sreekondapalli17/neonwrist/(list of files, drawings)

Other design files:
pcb/neonwrist/neonwrist.dsn
pcb/neonwrist/temp-freerouting.dsn
