sreekondapalli17/neonwrist/pcb/neonwrist/neonwrist.kicad_pcb

## KiCad design pcb/neonwrist/neonwrist.kicad_pcb (2026-11-05)

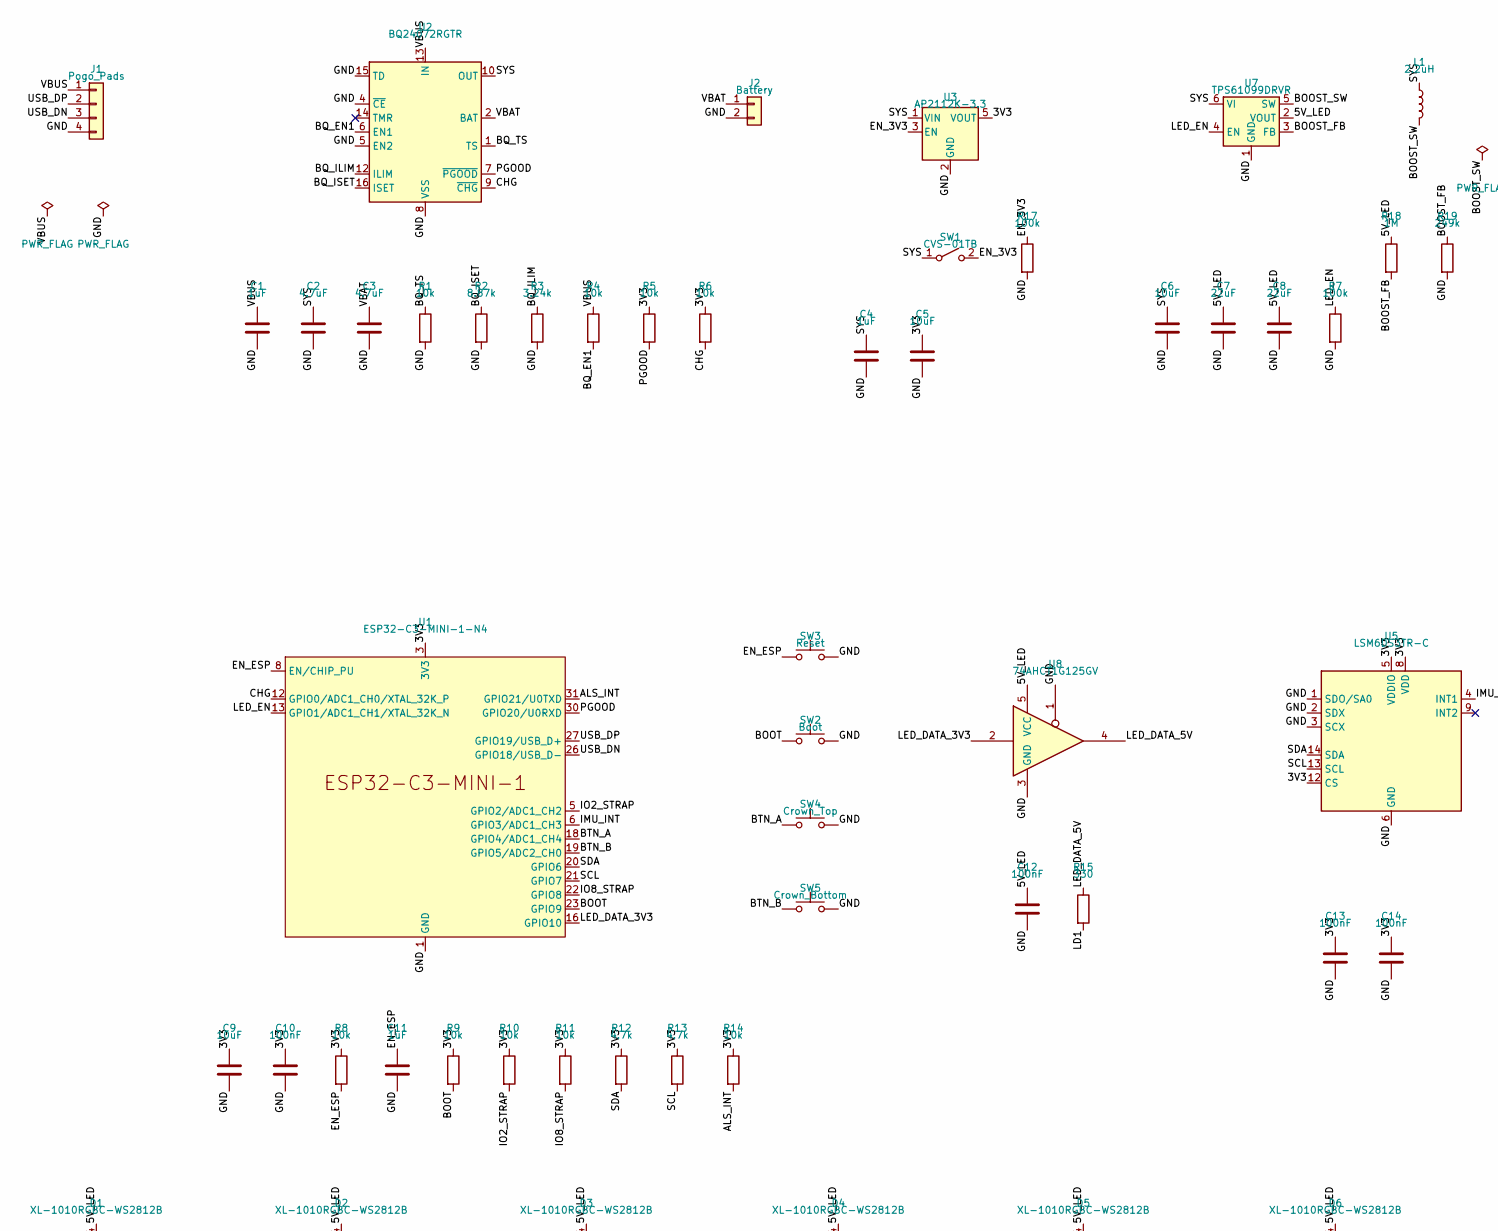
[picture p1: schematic neonwrist.kicad_sch, NEON//WRIST MK-II main board, part in row 1, column 1]

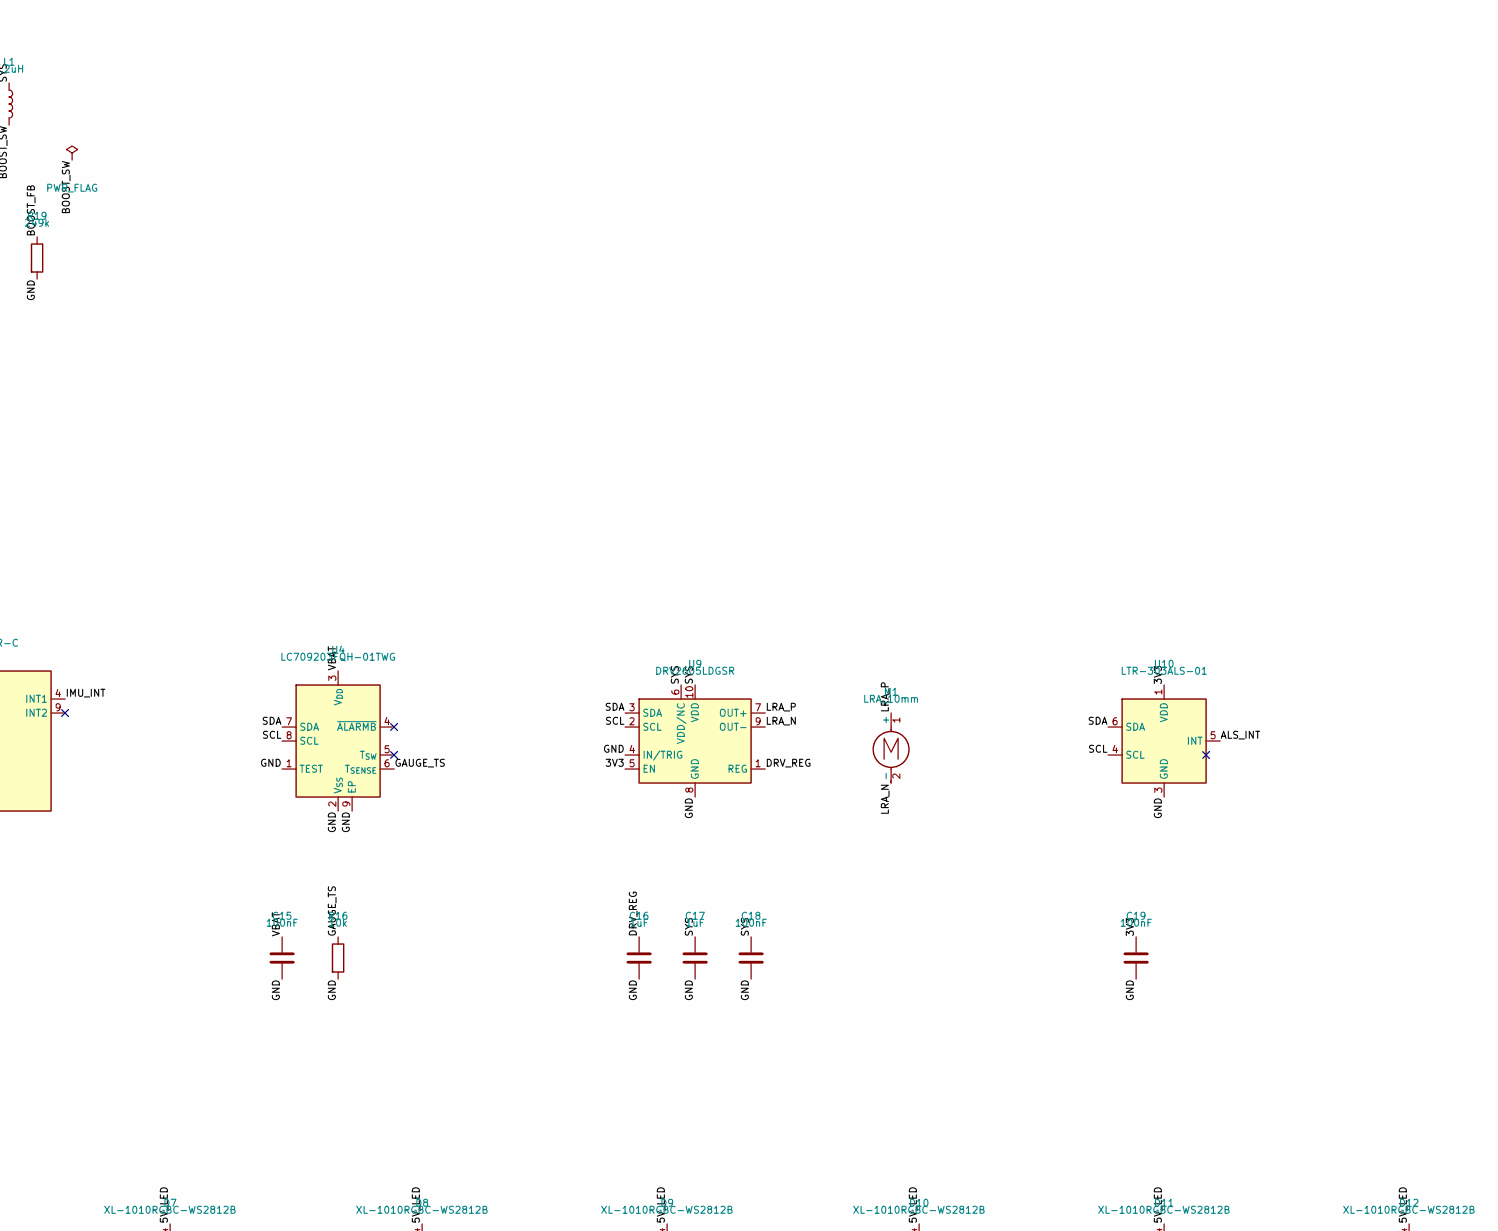
[picture p2: schematic neonwrist.kicad_sch, NEON//WRIST MK-II main board, part in row 1, column 2]

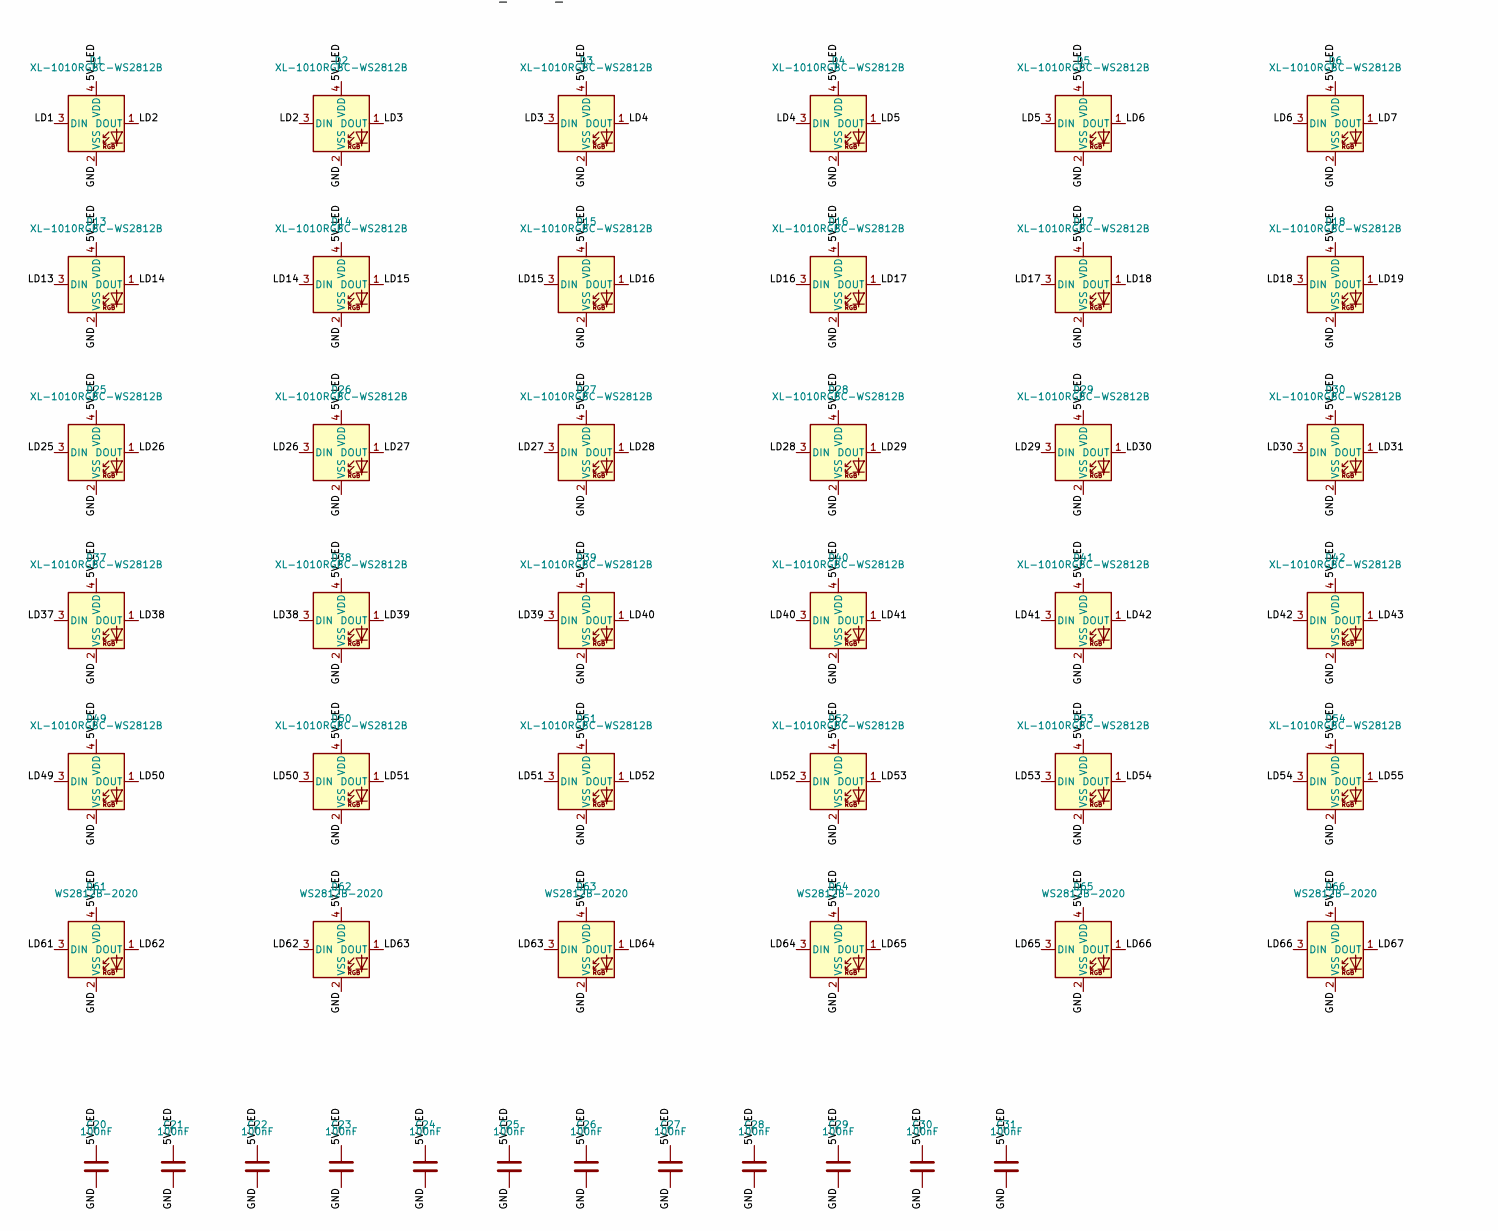
[picture p3: schematic neonwrist.kicad_sch, NEON//WRIST MK-II main board, part in row 2, column 1]

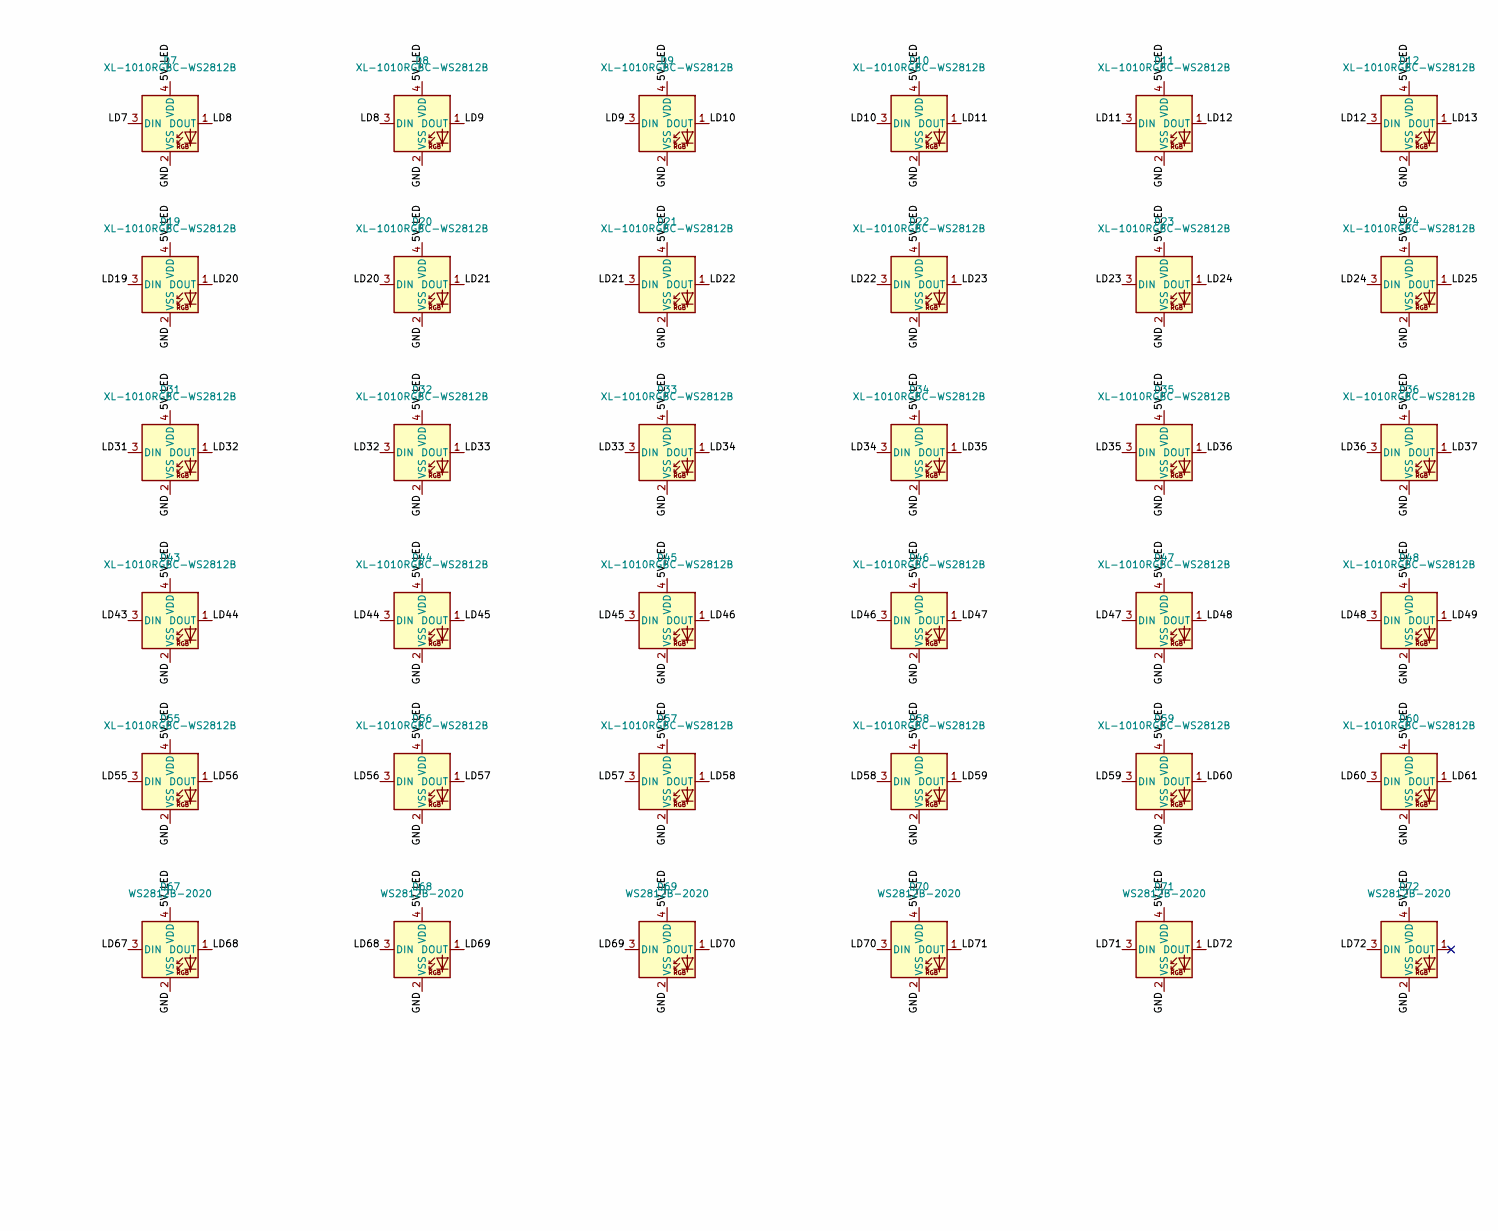
[picture p4: schematic neonwrist.kicad_sch, NEON//WRIST MK-II main board, part in row 2, column 2]

Parts:
C1, C4, C11, C16, C17: 1uF; C_0402_1005Metric
C2, C3: 4.7uF; C_0603_1608Metric
C5, C6, C9: 10uF; C_0603_1608Metric
C7, C8: 22uF; C_0603_1608Metric
C10, C12, C13, C14, C15, C18, C19, C20, C21, C22, C23, C24, C25, C26, C27, C28, C29, C30, C31: 100nF; C_0402_1005Metric
D1, D2, D3, D4, D5, D6, D7, D8, D9, D10, D11, D12, D13, D14, D15, D16, D17, D18, D19, D20, D21, D22, D23, D24, D25, D26, D27, D28, D29, D30, D31, D32, D33, D34, D35, D36, D37, D38, D39, D40, D41, D42, D43, D44, D45, D46, D47, D48, D49, D50, D51, D52, D53, D54, D55, D56, D57, D58, D59, D60: XL-1010RGBC-WS2812B; LED_XL-1010RGBC_1.0x1.0mm
D61, D62, D63, D64, D65, D66, D67, D68, D69, D70, D71, D72: WS2812B-2020; LED_WS2812B-2020_PLCC4_2.0x2.0mm
J1: Pogo_Pads; Pogo_4Pad_P2.5mm
J2: Battery; Battery_2Pad
L1: 2.2uH; L_1008_2520Metric
M1: LRA_10mm; LRA_2Pad
R1, R4, R5, R6, R8, R9, R10, R11, R14, R16: 10k; R_0402_1005Metric
R2: 8.87k; R_0402_1005Metric
R3: 3.24k; R_0402_1005Metric
R7, R17: 100k; R_0402_1005Metric
R12, R13: 4.7k; R_0402_1005Metric
R15: 330; R_0402_1005Metric
R18: 1M; R_0402_1005Metric
R19: 249k; R_0402_1005Metric
SW1: CVS-01TB; SW_DIP_SPSTx01_Slide_Copal_CVS-01xB_W5.9mm_P1mm
SW2: Boot; Panasonic_EVQPUJ_EVQPUA
SW3: Reset; Panasonic_EVQPUJ_EVQPUA
SW4: Crown_Top; Panasonic_EVQPUJ_EVQPUA
SW5: Crown_Bottom; Panasonic_EVQPUJ_EVQPUA
U1: ESP32-C3-MINI-1-N4; ESP32-C3-MINI-1
U2: BQ24072RGTR; VQFN-16-1EP_3x3mm_P0.5mm_EP1.6x1.6mm
U3: AP2112K-3.3; SOT-23-5
U4: LC709203FQH-01TWG; WDFN-8-1EP_4x3mm_P0.65mm_EP2.4x1.8mm
U5: LSM6DS3TR-C; LGA-14_3x2.5mm_P0.5mm_LayoutBorder3x4y
U7: TPS61099DRVR; WSON-6-1EP_2x2mm_P0.65mm_EP1x1.6mm
U8: 74AHCT1G125GV; SOT-23-5
U9: DRV2605LDGSR; MSOP-10_3x3mm_P0.5mm
U10: LTR-303ALS-01; Lite-On_LTR-303ALS-01

Connections:
/3V3: C5.1, C9.1, C10.1, C13.1, C14.1, C19.1, R5.1, R6.1, R8.1, R9.1, R10.1, R11.1, R12.1, R13.1, R14.1, U1.3 (3V3), U3.5 (VOUT), U5.5 (VDDIO), U5.8 (VDD), U5.12 (CS), U9.5 (EN), U10.1 (VDD)
/5V_LED: C7.1, C8.1, C12.1, C20.1, C21.1, C22.1, C23.1, C24.1, C25.1, C26.1, C27.1, C28.1, C29.1, C30.1, C31.1, D1.4 (VDD), D2.4 (VDD), D3.4 (VDD), D4.4 (VDD), D5.4 (VDD), D6.4 (VDD), D7.4 (VDD), D8.4 (VDD), D9.4 (VDD), D10.4 (VDD), D11.4 (VDD), D12.4 (VDD), D13.4 (VDD), D14.4 (VDD), D15.4 (VDD), D16.4 (VDD), D17.4 (VDD), D18.4 (VDD), D19.4 (VDD), D20.4 (VDD), D21.4 (VDD), D22.4 (VDD), D23.4 (VDD), D24.4 (VDD), D25.4 (VDD), D26.4 (VDD), D27.4 (VDD), D28.4 (VDD), D29.4 (VDD), D30.4 (VDD), D31.4 (VDD), D32.4 (VDD), D33.4 (VDD), D34.4 (VDD), D35.4 (VDD), D36.4 (VDD), D37.4 (VDD), D38.4 (VDD), D39.4 (VDD), D40.4 (VDD), D41.4 (VDD), D42.4 (VDD), D43.4 (VDD), D44.4 (VDD), D45.4 (VDD), D46.4 (VDD), D47.4 (VDD), D48.4 (VDD), D49.4 (VDD), D50.4 (VDD), D51.4 (VDD), D52.4 (VDD), D53.4 (VDD), D54.4 (VDD), D55.4 (VDD), D56.4 (VDD), D57.4 (VDD), D58.4 (VDD), D59.4 (VDD), D60.4 (VDD), D61.4 (VDD), D62.4 (VDD), D63.4 (VDD), D64.4 (VDD), D65.4 (VDD), D66.4 (VDD), D67.4 (VDD), D68.4 (VDD), D69.4 (VDD), D70.4 (VDD), D71.4 (VDD), D72.4 (VDD), R18.1, U7.2 (VOUT), U8.5 (VCC)
/ALS_INT: R14.2, U1.31 (GPIO21/U0TXD), U10.5 (INT)
/BOOST_FB: R18.2, R19.1, U7.3 (FB)
/BOOST_SW: L1.2, U7.5 (SW)
/BOOT: R9.2, SW2.1, U1.23 (GPIO9)
/BQ_EN1: R4.2, U2.6 (EN1)
/BQ_ILIM: R3.1, U2.12 (ILIM)
/BQ_ISET: R2.1, U2.16 (ISET)
/BQ_TS: R1.1, U2.1 (TS)
/BTN_A: SW4.1, U1.18 (GPIO4/ADC1_CH4)
/BTN_B: SW5.1, U1.19 (GPIO5/ADC2_CH0)
/CHG: R6.2, U1.12 (GPIO0/ADC1_CH0/XTAL_32K_P), U2.9 (~CHG)
/DRV_REG: C16.1, U9.1 (REG)
/EN_3V3: R17.1, SW1.2 (B), U3.3 (EN)
/EN_ESP: C11.1, R8.2, SW3.1, U1.8 (EN/CHIP_PU)
/GAUGE_TS: R16.1, U4.6 (T_{SENSE})
/GND: C1.2, C2.2, C3.2, C4.2, C5.2, C6.2, C7.2, C8.2, C9.2, C10.2, C11.2, C12.2, C13.2, C14.2, C15.2, C16.2, C17.2, C18.2, C19.2, C20.2, C21.2, C22.2, C23.2, C24.2, C25.2, C26.2, C27.2, C28.2, C29.2, C30.2, C31.2, D1.2 (VSS), D2.2 (VSS), D3.2 (VSS), D4.2 (VSS), D5.2 (VSS), D6.2 (VSS), D7.2 (VSS), D8.2 (VSS), D9.2 (VSS), D10.2 (VSS), D11.2 (VSS), D12.2 (VSS), D13.2 (VSS), D14.2 (VSS), D15.2 (VSS), D16.2 (VSS), D17.2 (VSS), D18.2 (VSS), D19.2 (VSS), D20.2 (VSS), D21.2 (VSS), D22.2 (VSS), D23.2 (VSS), D24.2 (VSS), D25.2 (VSS), D26.2 (VSS), D27.2 (VSS), D28.2 (VSS), D29.2 (VSS), D30.2 (VSS), D31.2 (VSS), D32.2 (VSS), D33.2 (VSS), D34.2 (VSS), D35.2 (VSS), D36.2 (VSS), D37.2 (VSS), D38.2 (VSS), D39.2 (VSS), D40.2 (VSS), D41.2 (VSS), D42.2 (VSS), D43.2 (VSS), D44.2 (VSS), D45.2 (VSS), D46.2 (VSS), D47.2 (VSS), D48.2 (VSS), D49.2 (VSS), D50.2 (VSS), D51.2 (VSS), D52.2 (VSS), D53.2 (VSS), D54.2 (VSS), D55.2 (VSS), D56.2 (VSS), D57.2 (VSS), D58.2 (VSS), D59.2 (VSS), D60.2 (VSS), D61.2 (VSS), D62.2 (VSS), D63.2 (VSS), D64.2 (VSS), D65.2 (VSS), D66.2 (VSS), D67.2 (VSS), D68.2 (VSS), D69.2 (VSS), D70.2 (VSS), D71.2 (VSS), D72.2 (VSS), J1.4, J2.2, R1.2, R2.2, R3.2, R7.2, R16.2, R17.2, R19.2, SW2.2, SW3.2, SW4.2, SW5.2, U1.1 (GND), U1.2 (GND), U1.11 (GND), U1.14 (GND), U1.36 (GND), U1.37 (GND), U1.38 (GND), U1.39 (GND), U1.40 (GND), U1.41 (GND), U1.42 (GND), U1.43 (GND), U1.44 (GND), U1.45 (GND), U1.46 (GND), U1.47 (GND), U1.48 (GND), U1.49 (GND), U1.50 (GND), U1.51 (GND), U1.52 (GND), U1.53 (GND), U2.4 (~CE), U2.5 (EN2), U2.8 (VSS), U2.15 (TD), U2.17 (VSS), U3.2 (GND), U4.1 (TEST), U4.2 (V_{SS}), U4.9 (EP), U5.1 (SDO/SA0), U5.2 (SDX), U5.3 (SCX), U5.6 (GND), U5.7 (GND), U7.1 (GND), U7.7 (GND), U8.1, U8.3 (GND), U9.4 (IN/TRIG), U9.8 (GND), U10.3 (GND)
/IMU_INT: U1.6 (GPIO3/ADC1_CH3), U5.4 (INT1)
/IO2_STRAP: R10.2, U1.5 (GPIO2/ADC1_CH2)
/IO8_STRAP: R11.2, U1.22 (GPIO8)
/LD1: D1.3 (DIN), R15.2
/LD2: D1.1 (DOUT), D2.3 (DIN)
/LD3: D2.1 (DOUT), D3.3 (DIN)
/LD4: D3.1 (DOUT), D4.3 (DIN)
/LD5: D4.1 (DOUT), D5.3 (DIN)
/LD6: D5.1 (DOUT), D6.3 (DIN)
/LD7: D6.1 (DOUT), D7.3 (DIN)
/LD8: D7.1 (DOUT), D8.3 (DIN)
/LD9: D8.1 (DOUT), D9.3 (DIN)
/LD10: D9.1 (DOUT), D10.3 (DIN)
/LD11: D10.1 (DOUT), D11.3 (DIN)
/LD12: D11.1 (DOUT), D12.3 (DIN)
/LD13: D12.1 (DOUT), D13.3 (DIN)
/LD14: D13.1 (DOUT), D14.3 (DIN)
/LD15: D14.1 (DOUT), D15.3 (DIN)
/LD16: D15.1 (DOUT), D16.3 (DIN)
/LD17: D16.1 (DOUT), D17.3 (DIN)
/LD18: D17.1 (DOUT), D18.3 (DIN)
/LD19: D18.1 (DOUT), D19.3 (DIN)
/LD20: D19.1 (DOUT), D20.3 (DIN)
/LD21: D20.1 (DOUT), D21.3 (DIN)
/LD22: D21.1 (DOUT), D22.3 (DIN)
/LD23: D22.1 (DOUT), D23.3 (DIN)
/LD24: D23.1 (DOUT), D24.3 (DIN)
/LD25: D24.1 (DOUT), D25.3 (DIN)
/LD26: D25.1 (DOUT), D26.3 (DIN)
/LD27: D26.1 (DOUT), D27.3 (DIN)
/LD28: D27.1 (DOUT), D28.3 (DIN)
/LD29: D28.1 (DOUT), D29.3 (DIN)
/LD30: D29.1 (DOUT), D30.3 (DIN)
/LD31: D30.1 (DOUT), D31.3 (DIN)
/LD32: D31.1 (DOUT), D32.3 (DIN)
/LD33: D32.1 (DOUT), D33.3 (DIN)
/LD34: D33.1 (DOUT), D34.3 (DIN)
/LD35: D34.1 (DOUT), D35.3 (DIN)
/LD36: D35.1 (DOUT), D36.3 (DIN)
/LD37: D36.1 (DOUT), D37.3 (DIN)
/LD38: D37.1 (DOUT), D38.3 (DIN)
/LD39: D38.1 (DOUT), D39.3 (DIN)
/LD40: D39.1 (DOUT), D40.3 (DIN)
/LD41: D40.1 (DOUT), D41.3 (DIN)
/LD42: D41.1 (DOUT), D42.3 (DIN)
/LD43: D42.1 (DOUT), D43.3 (DIN)
/LD44: D43.1 (DOUT), D44.3 (DIN)
/LD45: D44.1 (DOUT), D45.3 (DIN)
/LD46: D45.1 (DOUT), D46.3 (DIN)
/LD47: D46.1 (DOUT), D47.3 (DIN)
/LD48: D47.1 (DOUT), D48.3 (DIN)
/LD49: D48.1 (DOUT), D49.3 (DIN)
/LD50: D49.1 (DOUT), D50.3 (DIN)
/LD51: D50.1 (DOUT), D51.3 (DIN)
/LD52: D51.1 (DOUT), D52.3 (DIN)
/LD53: D52.1 (DOUT), D53.3 (DIN)
/LD54: D53.1 (DOUT), D54.3 (DIN)
/LD55: D54.1 (DOUT), D55.3 (DIN)
/LD56: D55.1 (DOUT), D56.3 (DIN)
/LD57: D56.1 (DOUT), D57.3 (DIN)
/LD58: D57.1 (DOUT), D58.3 (DIN)
/LD59: D58.1 (DOUT), D59.3 (DIN)
/LD60: D59.1 (DOUT), D60.3 (DIN)
/LD61: D60.1 (DOUT), D61.3 (DIN)
/LD62: D61.1 (DOUT), D62.3 (DIN)
/LD63: D62.1 (DOUT), D63.3 (DIN)
/LD64: D63.1 (DOUT), D64.3 (DIN)
/LD65: D64.1 (DOUT), D65.3 (DIN)
/LD66: D65.1 (DOUT), D66.3 (DIN)
/LD67: D66.1 (DOUT), D67.3 (DIN)
/LD68: D67.1 (DOUT), D68.3 (DIN)
/LD69: D68.1 (DOUT), D69.3 (DIN)
/LD70: D69.1 (DOUT), D70.3 (DIN)
/LD71: D70.1 (DOUT), D71.3 (DIN)
/LD72: D71.1 (DOUT), D72.3 (DIN)
/LED_DATA_3V3: U1.16 (GPIO10), U8.2
/LED_DATA_5V: R15.1, U8.4
/LED_EN: R7.1, U1.13 (GPIO1/ADC1_CH1/XTAL_32K_N), U7.4 (EN)
/LRA_N: M1.2 (-), U9.9 (OUT-)
/LRA_P: M1.1 (+), U9.7 (OUT+)
/PGOOD: R5.2, U1.30 (GPIO20/U0RXD), U2.7 (~PGOOD)
/SCL: R13.2, U1.21 (GPIO7), U4.8 (SCL), U5.13 (SCL), U9.2 (SCL), U10.4 (SCL)
/SDA: R12.2, U1.20 (GPIO6), U4.7 (SDA), U5.14 (SDA), U9.3 (SDA), U10.6 (SDA)
/SYS: C2.1, C4.1, C6.1, C17.1, C18.1, L1.1, SW1.1 (A), U2.10 (OUT), U2.11 (OUT), U3.1 (VIN), U7.6 (VI), U9.6 (VDD/NC), U9.10 (VDD)
/USB_DN: J1.3, U1.26 (GPIO18/USB_D-)
/USB_DP: J1.2, U1.27 (GPIO19/USB_D+)
/VBAT: C3.1, C15.1, J2.1, U2.2 (BAT), U2.3 (BAT), U4.3 (V_{DD})
/VBUS: C1.1, J1.1, R4.1, U2.13 (IN)

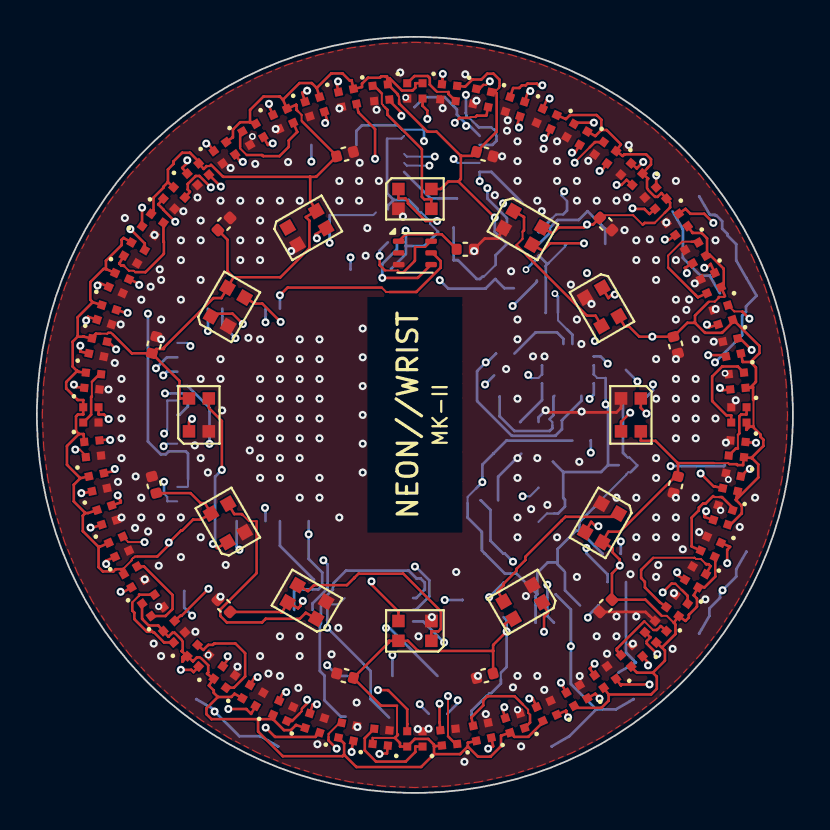
[picture p5: board neonwrist.kicad_pcb from above]

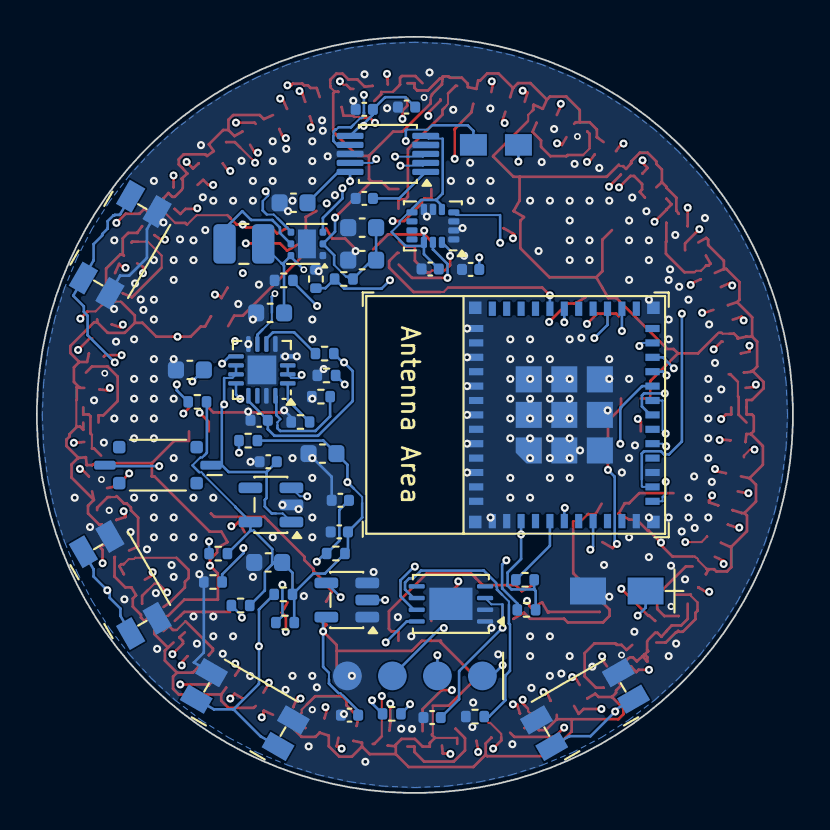
[picture p6: board neonwrist.kicad_pcb from below]

Board: 4 copper layers, 42.0 x 42.0 mm, 140 parts (54 on the bottom side), 106 nets.
