sreekondapalli17/neonwrist/(commit log)

2026-10-23 Wire USB-C, charger, battery connector
    [neonwrist.kicad_pcb, neonwrist.kicad_sch]
2026-10-23 Stop tracking KiCad local history
2026-11-05 Save schematic before label rewrite
    [neonwrist.kicad_pcb, neonwrist.kicad_sch]
2026-11-05 MK-II schematic, footprints, placement
    [neonwrist.kicad_pcb, neonwrist.kicad_sch]
2026-11-05 MK-II schematic, footprints, placement fixes
    [neonwrist.kicad_sch]
2026-11-05 MK-II placement script v3
    [neonwrist.kicad_pcb]
2026-11-05 MK-II power switch swap and placement v4
    [neonwrist.kicad_sch]
2026-11-05 MK-II placement and routing prep
    [neonwrist.dsn, neonwrist.kicad_pcb, neonwrist.kicad_sch]
2026-11-05 MK-II fixes
    [neonwrist.dsn]
2026-11-05 MK-II routing
    [neonwrist.kicad_pcb, temp-freerouting.dsn]
2026-11-05 Main board routed, DRC clean
    [neonwrist.kicad_pcb]
2026-11-05 Face logo + gerbers
    [neonwrist-B_Cu.gbl, neonwrist-B_Mask.gbs, neonwrist-B_Paste.gbp, neonwrist-B_Silkscreen.gbo, neonwrist-Edge_Cuts.gm1, neonwrist-F_Cu.gtl, neonwrist-F_Mask.gts, neonwrist-F_Paste.gtp]
2026-11-05 Boost fix, DRC clean, new gerbers
    [neonwrist-B_Cu.gbl, neonwrist-B_Mask.gbs, neonwrist-B_Paste.gbp, neonwrist-B_Silkscreen.gbo, neonwrist-Edge_Cuts.gm1, neonwrist-F_Cu.gtl, neonwrist-F_Mask.gts, neonwrist-F_Paste.gtp]
